Allen2910/Pump-Free-Single-Phase-Immersion-Cooling-Combined-with-Heat-Pipes-/Simulation_and_Experiment_Validation_of_Single_Phase_Immersion_Cooling_System_Combined_with_Heat_Pipes.pdf

# Simulation andExperimental Validation of Single-Phase Immersion Cooling System Combined withHeat Pipes

## Author: Jui-Chieh Lee, Syu-Siang Yu, Chao-Han Liu Professor: Jenn-Kun Kuo

Department of Mechanical and Electro-Mechanical Engineering , National Sun Yat-sen University, Kaohsiung, Taiwan, R.O.C.

## Introduction

Driven by AI’s surging computing demand, data center cooling is projected to consume 40% of total electricity by 2030, resulting in a high PUE of around
1.6. Traditional single-phase immersion cooling (SPIC) relies on power-consuming external water pumps, which causes localized heat accumulation at low flow rates. To address this, we propose a low-energy, pump-free SPIC design combining finned heat pipes and an internal circulation fan. The internal fan effectively breaks the thermal boundary layer, enabling the heat pipes to dissipate a 100W heat load through phase-change heat transfer. By completely eliminating external pumps, this design minimizes non-computing energy consumption, aiming to achieve an optimal PUE below 1.3.

## Problem Statement

Traditional single-phase immersion cooling (SPIC) systems heavily rely on external water pumps for fluid circulation, which significantly increases non-computing energy consumption and overall PUE. However, simply eliminating the external pump to save energy creates a new challenge: the lack of external forced convection causes severe localized heat accumulation on the surface of working components. At low flow rates, natural convection is insufficient, leading to the formation of a thermal boundary layer around the high-power chips. Therefore, the core problem is how to effectively implement internal flow disruption to break the thermal boundary layer and prevent temperature surging, entirely without the energy penalty of external pumps.

## Design and Methods

This study integrates practical prototype experiments and numerical simulations to evaluate the pump-free cooling system.

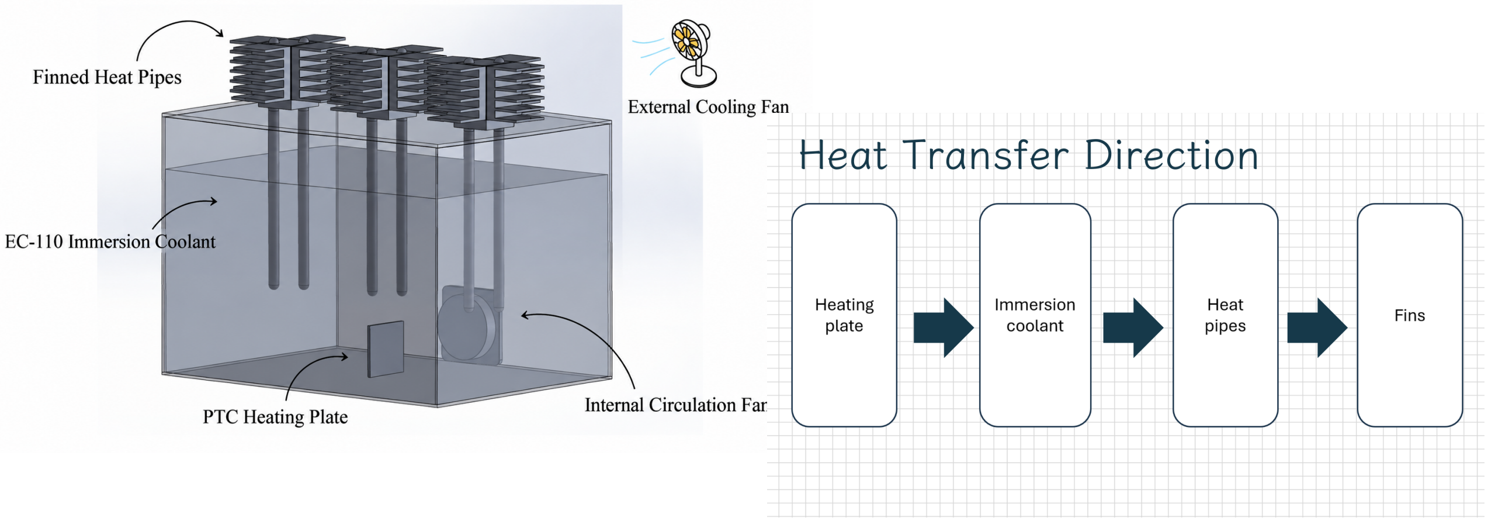
[picture p6: figure]

Fig. 1. Experimental setup of the pump-free cooling system.

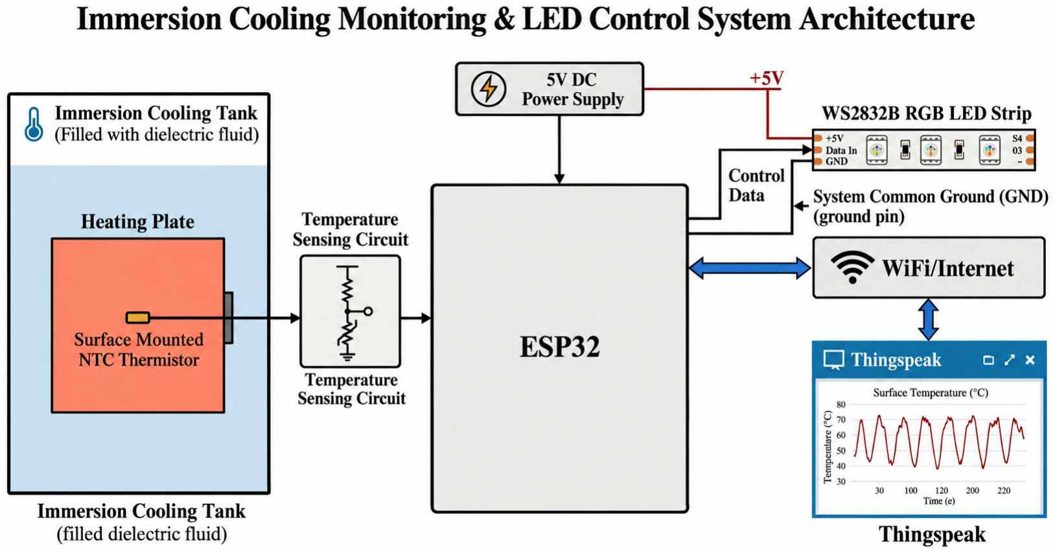
[picture p7: figure]

Fig. 2. Heat transfer path diagram. | Fig. 3. Temperature measurement
| system.

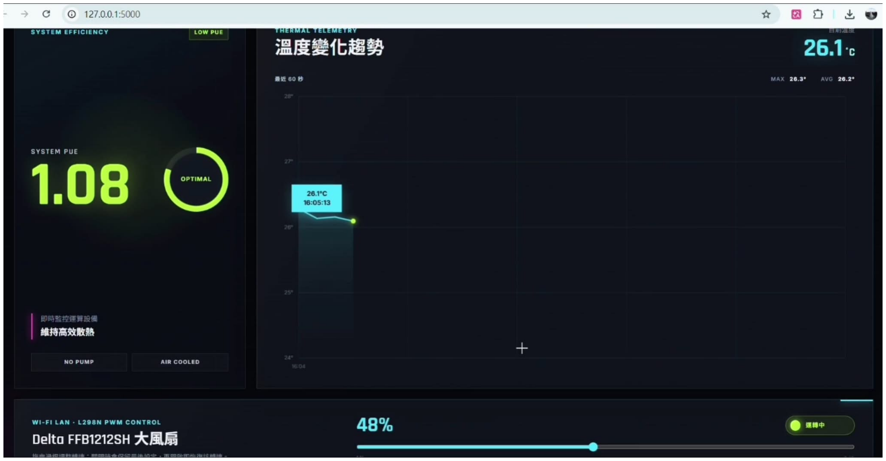
[picture p8: figure]

Fig. 4. Detect the temperature and PUE in time.

## Simulation and Results

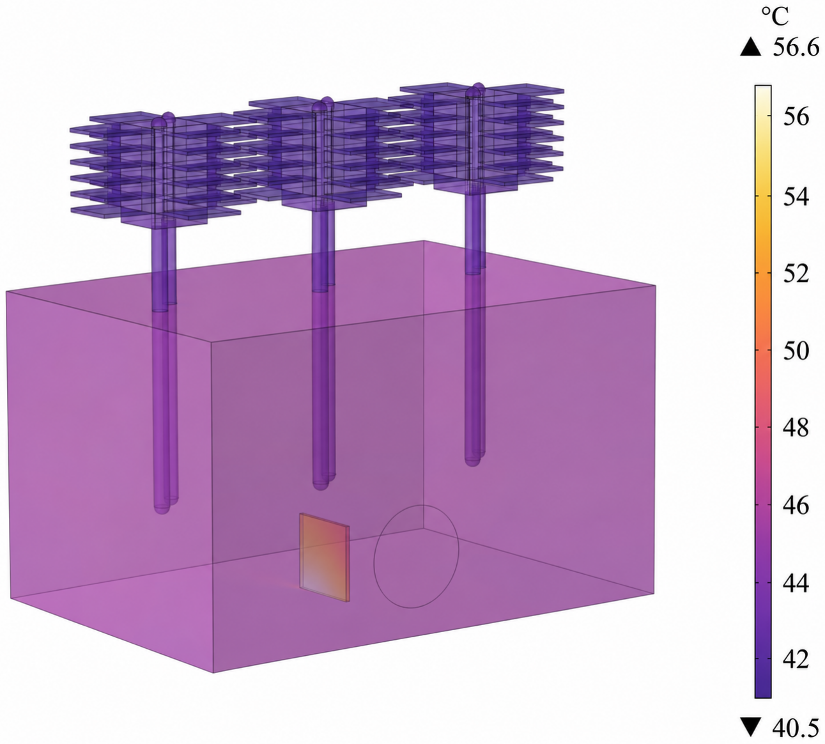
[picture p9: figure]

Fig. 5. COMSOL Simulation result. It
demonstrates the temperature distribution in this system and the maximum temperature is lower than the limit 85°C.

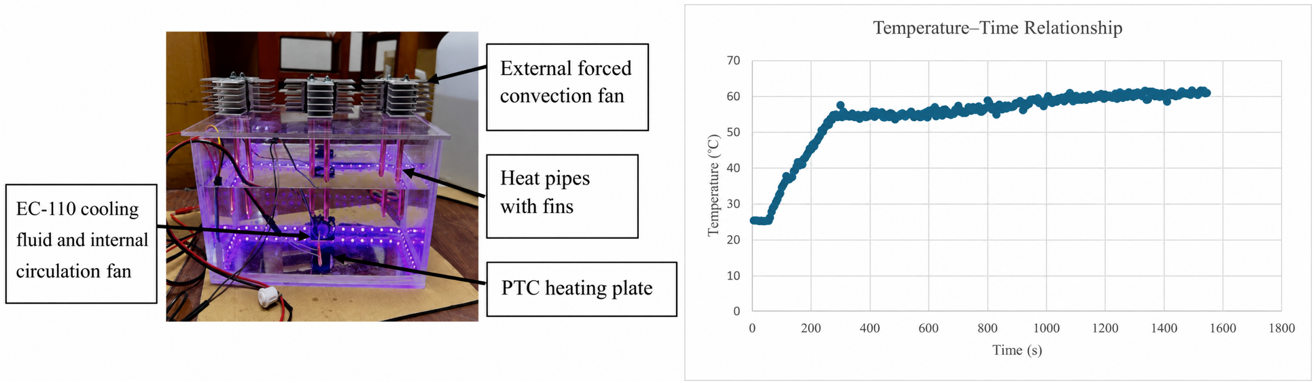
[picture p10: figure]

Fig. 6. Practical model. The prototype of the pump-free immersion cooling system, featuring finned heat pipes, an internal circulation fan, and a PTC heating plate.

Fig. 7. Temperature-Time relationship of the
heating plate.It demonstrates the system reaching thermal equilibrium at approximately 60°C.

## Conclusion

This study successfully demonstrates the feasibility of a pump-free single-phase immersion cooling (SPIC) system. By integrating an internal circulation fan and finned heat pipes, the system effectively breaks the thermal boundary layer and dissipates a 100W heat load without relying on external water pumps. Crucially, cross-verification between the practical prototype and COMSOL simulations yielded a steady-state error of less than 5%. This confirms that the numerical model accurately predicts the fluid and thermal field behaviors. Furthermore, this highly validated simulation model allows us to easily test different operating scenarios and optimize the system design in the future without incurring significant physical prototyping costs. Ultimately, this research establishes a reliable foundation for achieving an optimal PUE below 1.3.

## Acknowledgement

We sincerely thank Professor Jenn-Kun Kuo for his guidance and support throughout this research, as well as the laboratory members for their assistance with the experimental setup and data collection.

## Demo Video

Scan for demo video

References:
[1] Huang, Y. P., Ge, J. L., Chen, Y. P., & Zhang, C. B. (2023). Natural and forced convection heat transfer characteristics of single-phase immersion cooling systems for data centers.
[2] Hansel, J. E., Ortensi, J., & Jaradat, M. K. (2025). Studies of the influence of heat pipe model and coupling strategy in heat pipe microreactor simulations using Sockeye.
[3] COMSOL. (2020). Heat pipe with accurate liquid and gas properties (Application ID: 90311).
